medo64/Januska/README.md

[Januska](https://medo64.com/januska/)
======================================

Januska allows for isolate communication on RS-485 bus.

Features:
* USB serial device supporting half-duplex RS-485 interface
* Supports 1 Mbps operation
* Automatic flow control
* Fully isolated (1 kV)
* Overvoltage protection (60V)
* USB 2.0 interface (type B)
* 3.81 mm strip headers bus connector

---
*You can check my blog and other projects at [www.medo64.com](https://medo64.com/electronics/).*
