medo64/Januska/Hardware/src/Januska [A].pdf

## USB_V+

10 uF

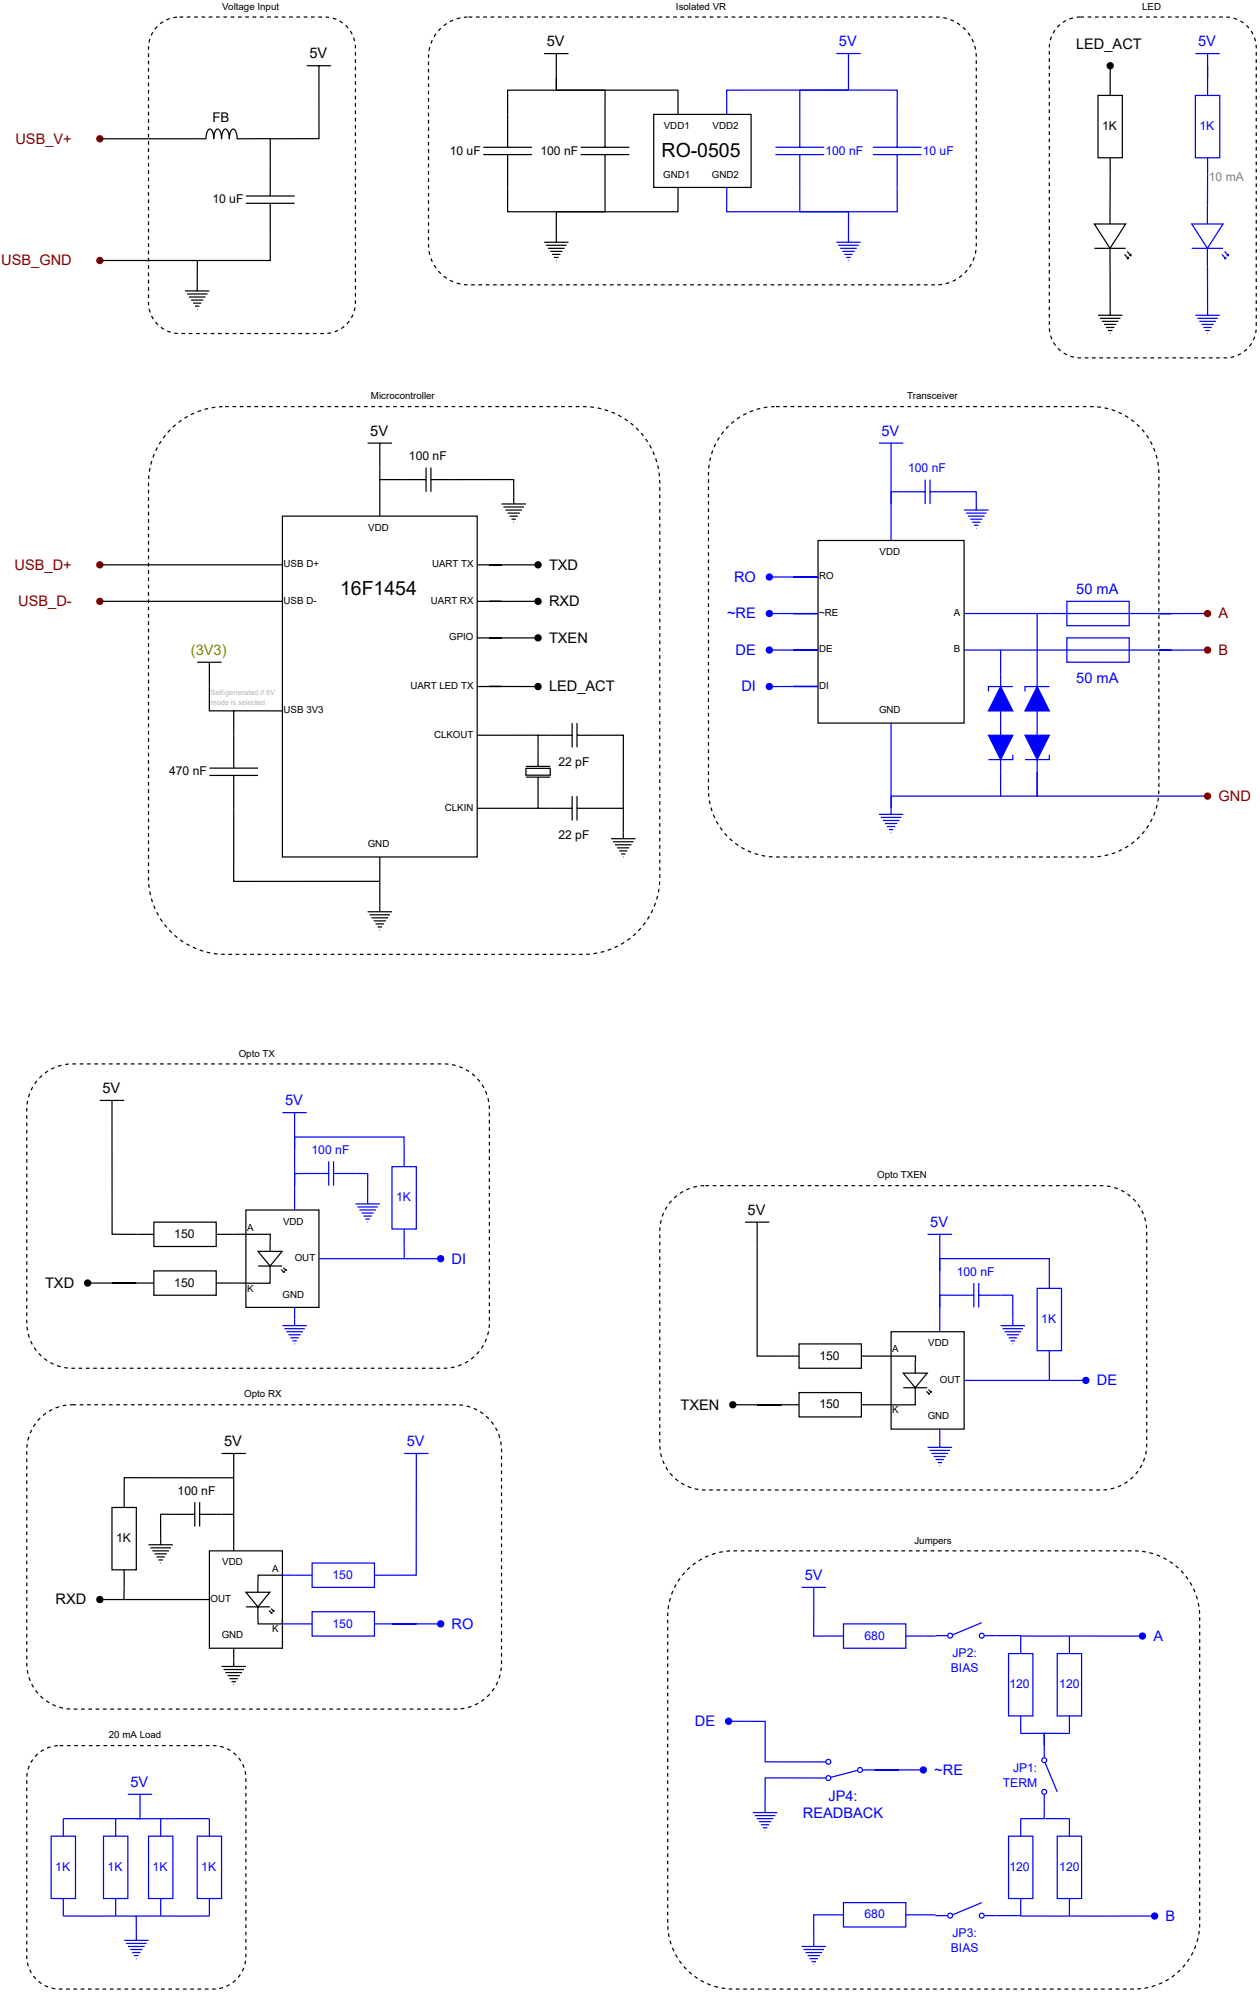
[picture p1: page 1]
Transceiver; Opto RX; Opto TX; Microcontroller; Voltage Input; LED; USB_GND; USB_D+; USB_D-; TXD; RXD; LED_ACT; TXEN; UART TX; USB D-; UART RX; VDD; GND; USB D+; CLKOUT; CLKIN; USB 3V3; GPIO; OUT; Opto TXEN; VDD1; GND1; VDD2; GND2; Isolated VR; JP4: READBACK; JP1: TERM; JP2: BIAS; JP3: BIAS; Jumpers; 20 mA Load

Self-generated if 5V mode is selected

UART LED TX
