medo64/Januska/(list of files, drawings)

Other design files:
Hardware/src/Januska [A].dip
