medo64/Januska/(commit log)

2022-07-04 Added LED to keep VR minimum current happy
    [Januska [A].dip]
2022-07-04 Added jumper for readback
    [Januska [A].dip]
2022-07-04 Updated 485 IC to one with thermal shutdown
    [Januska [A].dip]
2022-07-04 Added fuses to output lines
    [Januska [A].dip]
2022-07-04 Addded overvoltage protection to data lines
    [Januska [A].dip]
2022-07-04 Minor refactoring
    [Januska [A].dip]
2022-07-04 Minimum load current on isolated portion set to 20 mA
    [Januska [A].dip]
2022-07-04 Added extra zener diodes for ground shift cases
    [Januska [A].dip]
2022-07-05 Minor silk-screen refactoring
    [Januska [A].dip]
